PanBabinicz/tinyscope/hardware/kicad/tinyscope/tinyscope.kicad_pcb

## KiCad design TubesAndDrivers.kicad_sch

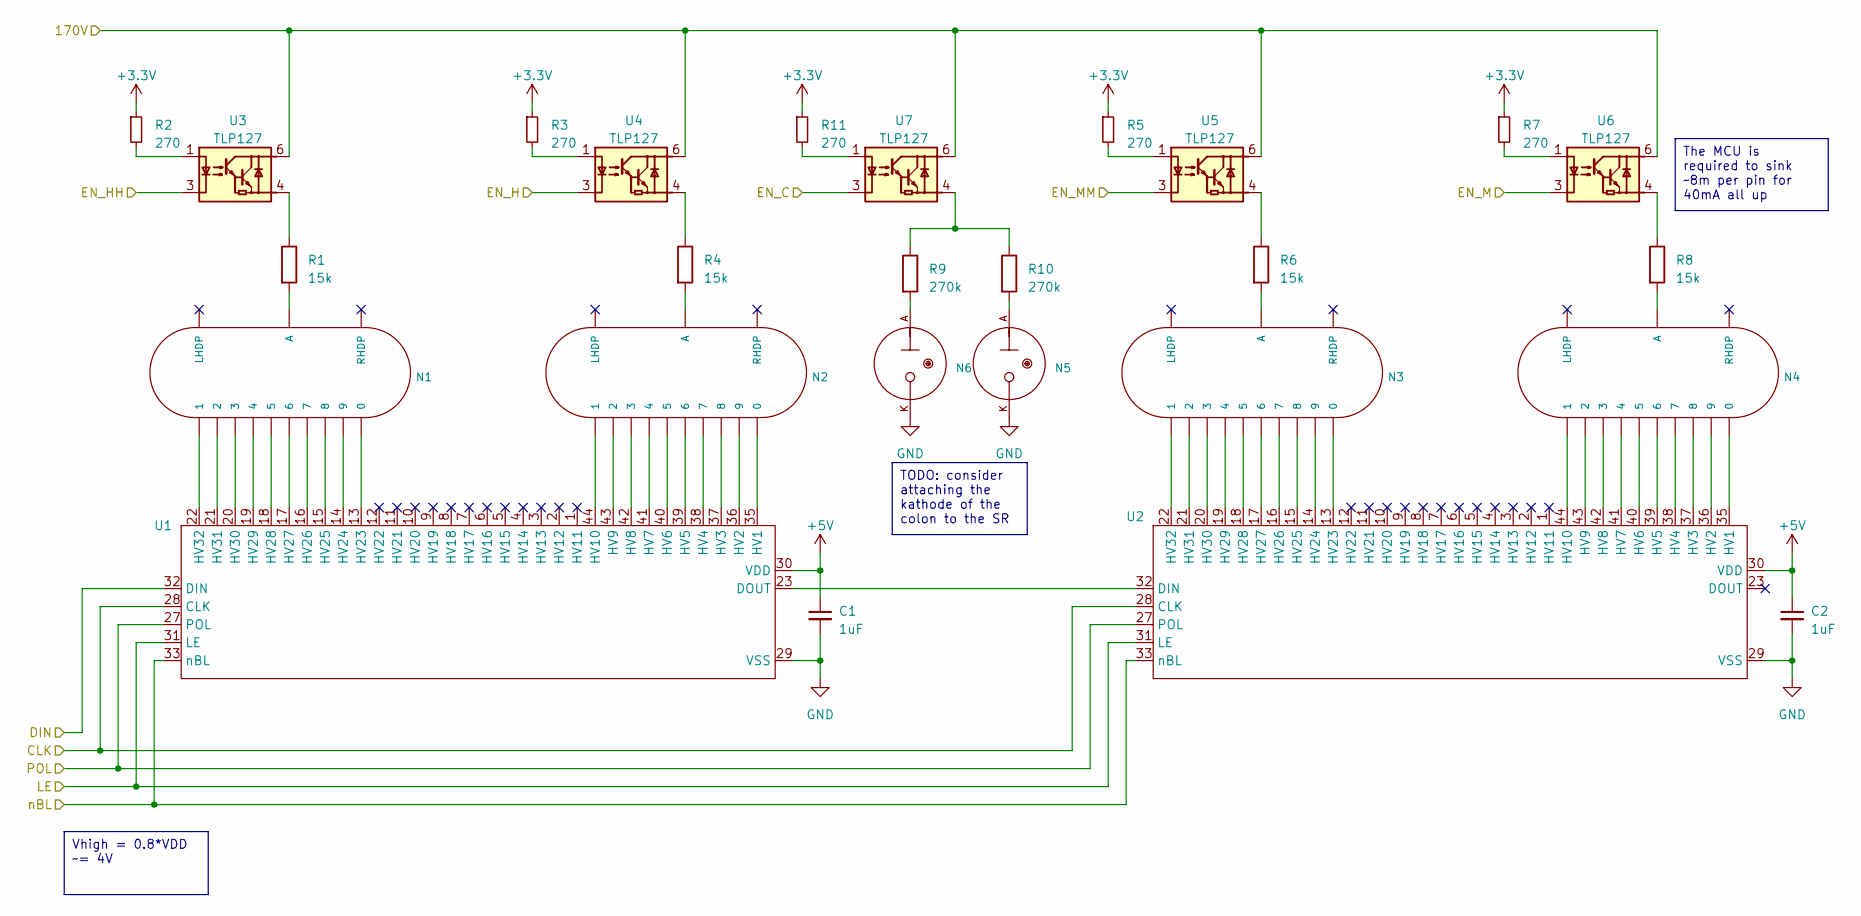
[picture p1: schematic TubesAndDrivers.kicad_sch]

Parts:
C1, C2: 1uF
N1, N2, N3, N4: IN-14; nixies-us_IN-14
N5, N6: IN-3; nixies-us_IN-3
R1, R4, R6, R8: 15k
R2, R3, R5, R7, R11: 270
R9, R10: 270k
U1, U2: QFN-44-1EP_7x7mm_P0.5mm_EP5.15x5.15mm
U3, U4, U5, U6, U7: TLP127; MFSOP6-4_4.4x3.6mm_P1.27mm

Connections:
170V: U3.6, U4.6, U5.6, U6.6, U7.6
+3.3V: R2.1, R3.1, R5.1, R7.1, R11.1
+5V: C1.1, C2.1, U1.30 (VDD), U2.30 (VDD)
CLK: U1.28 (CLK), U2.28 (CLK)
DIN: U1.32 (DIN)
EN_C: U7.3
EN_H: U4.3
EN_HH: U3.3
EN_M: U6.3
EN_MM: U5.3
GND: C1.2, C2.2, N5.K, N6.K, U1.29 (VSS), U1.45 (VSS), U2.29 (VSS), U2.45 (VSS)
LE: U1.31 (LE), U2.31 (LE)
unnamed: N1.0, U1.13 (HV23)
unnamed: N1.1, U1.22 (HV32)
unnamed: N1.2, U1.21 (HV31)
unnamed: N1.3, U1.20 (HV30)
unnamed: N1.4, U1.19 (HV29)
unnamed: N1.5, U1.18 (HV28)
unnamed: N1.6, U1.17 (HV27)
unnamed: N1.7, U1.16 (HV26)
unnamed: N1.8, U1.15 (HV25)
unnamed: N1.9, U1.14 (HV24)
unnamed: N1.A, R1.2
unnamed: N2.0, U1.35 (HV1)
unnamed: N2.1, U1.44 (HV10)
unnamed: N2.2, U1.43 (HV9)
unnamed: N2.3, U1.42 (HV8)
unnamed: N2.4, U1.41 (HV7)
unnamed: N2.5, U1.40 (HV6)
unnamed: N2.6, U1.39 (HV5)
unnamed: N2.7, U1.38 (HV4)
unnamed: N2.8, U1.37 (HV3)
unnamed: N2.9, U1.36 (HV2)
unnamed: N2.A, R4.2
unnamed: N3.0, U2.13 (HV23)
unnamed: N3.1, U2.22 (HV32)
unnamed: N3.2, U2.21 (HV31)
unnamed: N3.3, U2.20 (HV30)
unnamed: N3.4, U2.19 (HV29)
unnamed: N3.5, U2.18 (HV28)
unnamed: N3.6, U2.17 (HV27)
unnamed: N3.7, U2.16 (HV26)
unnamed: N3.8, U2.15 (HV25)
unnamed: N3.9, U2.14 (HV24)
unnamed: N3.A, R6.2
unnamed: N4.0, U2.35 (HV1)
unnamed: N4.1, U2.44 (HV10)
unnamed: N4.2, U2.43 (HV9)
unnamed: N4.3, U2.42 (HV8)
unnamed: N4.4, U2.41 (HV7)
unnamed: N4.5, U2.40 (HV6)
unnamed: N4.6, U2.39 (HV5)
unnamed: N4.7, U2.38 (HV4)
unnamed: N4.8, U2.37 (HV3)
unnamed: N4.9, U2.36 (HV2)
unnamed: N4.A, R8.2
unnamed: N5.A, R10.2
unnamed: N6.A, R9.2
unnamed: R1.1, U3.4
unnamed: R2.2, U3.1
unnamed: R3.2, U4.1
unnamed: R4.1, U4.4
unnamed: R5.2, U5.1
unnamed: R6.1, U5.4
unnamed: R7.2, U6.1
unnamed: R8.1, U6.4
unnamed: R9.1, R10.1, U7.4
unnamed: R11.2, U7.1
unnamed: U1.23 (DOUT), U2.32 (DIN)
unnamed: U1.25, U1.26, U1.34
unnamed: U2.25, U2.26, U2.34
POL: U1.27 (POL), U2.27 (POL)
nBL: U1.33 (nBL), U2.33 (nBL)

Notes on the sheet:
TODO: consider attaching the kathode of the colon to the SR
The MCU is required to sink ~8m per pin for 40mA all up
Vhigh = 0.8*VDD ~= 4V
