PanBabinicz/tinyscope/(commit log)

2026-05-31 feat: hardware: Add tinyscope kicad project. Add USBC part
    [tinyscope.kicad_pcb, tinyscope.kicad_sch]
2026-05-31 feat: hardware: Add tinyscope kicad project. Add USBC friendly battery charger part
    [tinyscope.kicad_sch]
2026-05-31 feat: hardware: Add tinyscope kicad project. Add fuel gauge part
    [tinyscope.kicad_sch]
2026-06-01 feat: hardware: Add tinyscope kicad project. Replace global labels with net labels
    [tinyscope.kicad_sch]
2026-06-01 feat: hardware: Add tinyscope kicad project. Add TPS54360 buck converter for battery #1
    [tinyscope.kicad_sch]
2026-06-02 feat: hardware: Add tinyscope kicad project. Add TPS54360 buck converter for battery #2. Add reverse-polarity and transient protection
    [tinyscope.kicad_sch]
2026-06-03 feat: hardware: Add tinyscope kicad project. Adds description blocks for Power Input & Charging section
    [tinyscope.kicad_sch]
2026-06-05 feat: hardware: Add tinyscope kicad project. Adds TPS62133 3V3 buck converter
    [tinyscope.kicad_sch]
2026-06-06 feat: hardware: Add tinyscope kicad project. Adds TPS63802 3V3 buck-boost converter instead of the previous one
    [tinyscope.kicad_sch]
2026-06-07 feat: hardware: Add tinyscope kicad project. Adds description to TPS63802 3V3 buck-boost converter
    [tinyscope.kicad_sch]
2026-06-07 feat: hardware: Add tinyscope kicad project. Adds TPS61023 5V boost voltage converter
    [tinyscope.kicad_sch]
2026-06-08 feat: hardware: Add tinyscope kicad project. Adds TPS63802 5V buck-boost converter instead of the TPS61023 (which input voltage range is too low)
    [tinyscope.kicad_sch]
2026-06-09 feat: hardware: Add tinyscope kicad project. Adds LM27761 -5V Switched-Capacitor Voltage Inverter
    [tinyscope.kicad_sch]
2026-06-10 feat: hardware: Add tinyscope kicad project. Adds REF3030 Voltage Reference 3.0V
    [tinyscope.kicad_sch]
2026-06-11 feat: hardware: Add tinyscope kicad project. Adds ADP742 low noise 5V LDO regulator
    [tinyscope.kicad_sch]
2026-06-12 feat: hardware: Add tinyscope kicad project. Divides project to subsheets. Adds power input and chargin sheet, regulation and rails sheet
    [power_and_charging.kicad_sch, regulation_and_rails.kicad_sch, tinyscope.kicad_sch]
2026-06-13 feat: hardware: Add tinyscope kicad project. Create flow diagram on Power Input & Charging schemat
    [tinyscope.kicad_sch]
2026-06-13 feat: hardware: Add tinyscope kicad project. Create flow diagram for Regulation & Rails schemat
    [regulation_and_rails.kicad_sch, tinyscope.kicad_sch]
2026-06-13 feat: doc: Adds stm32h753 reference manual and datasheet
2026-06-13 feat: hardware: Add tinyscope kicad project. Create flow diagram for MCUs sheet. Adds decoupling caps for STM32H743
    [mcus.kicad_sch, power_and_charging.kicad_sch, regulation_and_rails.kicad_sch, tinyscope.kicad_sch]
2026-06-14 feat: hardware: Add tinyscope kicad project. Adds SWD NRST and BOOT0
    [mcus.kicad_sch]
2026-06-15 feat: hardware: Add tinyscope kicad project. Adds HSE XTAL. Missing capacitor values
    [mcus.kicad_sch]
2026-06-15 feat: hardware: Add tinyscope kicad project. Adds LSE XTAL. Missing capacitor values
    [mcus.kicad_sch]
2026-06-16 feat: hardware: Add tinyscope kicad project. Divide MCU schematic into acquisition and wireless parts
    [mcus_acquisition.kicad_sch, tinyscope.kicad_sch]
2026-06-16 feat: hardware: Add tinyscope kicad project. Initializes MCU wireless schematic
    [mcu_wireless.kicad_sch]
2026-06-17 feat: hardware: Add tinyscope kicad project. Adds Raytac MDBT50Q #1
    [mcu_wireless.kicad_sch]
2026-06-18 feat: hardware: Add tinyscope kicad project. Adds Raytac MDBT50Q #2. Basic schemtic with TAG Connect
    [mcu_wireless.kicad_sch]
2026-06-18 feat: doc: Update schematics - title and revision
    [mcu_wireless.kicad_sch, mcus_acquisition.kicad_sch]
2026-06-19 feat: hardware: Add tinyscope kicad project. Add TAG Connect to STM32H743
    [mcus_acquisition.kicad_sch]
2026-06-19 feat: hardware: Add tinyscope kicad project. Adds STM32H743 SPI1 and SPI2 lines
    [mcu_wireless.kicad_sch, mcus_acquisition.kicad_sch]
2026-06-20 feat: hardware: Add tinyscope kicad project. Adds HMI schematic - display part #1
    [tinyscope.kicad_sch]
2026-06-20 feat: hardware: Add tinyscope kicad project. Adds ILI9341 display controller #1
    [hmi.kicad_sch]
2026-06-21 feat: doc: Adds AN2867 guidelines for oscillator design on STM32
2026-06-22 feat: hardware: Asigns load capacitors values for STM32H743 and saves crystals datasheet
    [mcu_wireless.kicad_sch, mcus_acquisition.kicad_sch]
2026-06-22 feat: hardware: Adds blue led mosfet driver for MDBT50Q
    [mcu_wireless.kicad_sch, power_and_charging.kicad_sch]
2026-06-23 feat: hardware: Finish MCU wireless schematic
    [mcu_wireless.kicad_sch, mcus_acquisition.kicad_sch]
2026-06-24 feat: hardware: Adds green led mosfet driver for STM32H743
    [mcus_acquisition.kicad_sch]
2026-06-25 feat: hardware: Adds five encoders in HMI schematic #1
    [hmi.kicad_sch]
2026-06-26 feat: hardware: Adds five encoders inputs on STM32H743
    [mcus_acquisition.kicad_sch]
2026-06-27 feat: hardware: Connects all five encoders to STM32H743
    [hmi.kicad_sch, mcus_acquisition.kicad_sch]
2026-06-28 feat: hardware: Adds RC filters for each A/B channels for all encoders
    [hmi.kicad_sch]
2026-06-30 feat: hardware: Adds RC filters for each switches for all encoders
    [hmi.kicad_sch]
2026-07-01 feat: hardware: Adds on/off switch for BQ24075
    [power_and_charging.kicad_sch]
2026-07-02 feat: hardware: Starts working on Front End A - general purpose
    [front_end.kicad_sch, tinyscope.kicad_sch]
2026-07-03 feat: hardware: Starts working on Front End B - ignition
    [tinyscope.kicad_sch]
2026-07-04 feat: hardware: Adds first stage TVS diodes for Front End A/B
    [front_end.kicad_sch]
2026-07-05 feat: hardware: Adds BV199 clamps and AD8065 buffers for Front End A/B
    [front_end.kicad_sch, regulation_and_rails.kicad_sch]
2026-07-06 feat: hardware: Finishes front ends stage 4
    [front_end.kicad_sch]
2026-07-07 feat: hardware: tidy: Adjust power and charging schematic to A4 format
    [power_and_charging.kicad_sch]
2026-07-08 feat: hardware: Add front ends stage 5. Replaces AD8065 with AD8066
    [front_end.kicad_sch]
2026-07-09 feat: hardware: note: The SPI1 has to be changed due to the fact that PA4 is used by DAC1_OUT
    [mcus_acquisition.kicad_sch]
2026-07-10 feat: hardware: Switches SPI1 to SPI4. Adds DAC1_OUT1 and DAC1_OUT2
    [front_end.kicad_sch, mcus_acquisition.kicad_sch]
2026-07-11 feat: hardware: Adds SPI4 connection on wireless mcu schematic
    [mcu_wireless.kicad_sch]
2026-07-12 feat: hardware: note: Starts the desing of the Sallen and Key Low Pass Filter filter (anti-aliasing)
    [front_end.kicad_sch]
2026-07-13 feat: hardware: note: Adds the two Sallen and Key Low Pass Filter filter (anti-aliasing) topologies
    [front_end.kicad_sch]
2026-07-14 feat: hardware: note: Adds the two Sallen and Key Low Pass Filter filter (anti-aliasing) parts values
    [front_end.kicad_sch]
2026-07-15 feat: hardware: Adds ADC12_INP3 and ADC12_INP4 fast channels
    [mcus_acquisition.kicad_sch]
2026-07-16 feat: hardware: note: Changes the caps values of two Sallen and Key Low Pass Filters (anti-aliasing) to match Butterworth filter
    [front_end.kicad_sch]
2026-07-18 feat: hardware: Adds the user input rotary encoders description. Changes 5V pull-up to 3V3
    [hmi.kicad_sch]
2026-07-19 feat: hardware: Adds wireless mcu description
    [mcu_wireless.kicad_sch]
2026-07-19 feat: hardware: Adds acquisition mcu description
    [mcus_acquisition.kicad_sch]
2026-07-20 feat: hardware: Adds decoupling capacitors for op amps and front end description
    [front_end.kicad_sch]
2026-07-21 feat: hardware: Adds rotary encoders on the main schematic
    [tinyscope.kicad_sch]
2026-07-23 feat: hardware: Adds Waveshare 16498 display 02x17 connector. Cleans up all schematics
    [hmi.kicad_sch, mcu_wireless.kicad_sch, mcus_acquisition.kicad_sch, power_and_charging.kicad_sch, regulation_and_rails.kicad_sch]
2026-07-24 feat: hardware: Modifies hmi description
    [hmi.kicad_sch]
2026-07-25 feat: hardware: Adds 6th encoder for display
    [hmi.kicad_sch]
2026-07-26 feat: hardware: doc: Modifies placement for the schematic description
    [front_end.kicad_sch, hmi.kicad_sch, mcu_wireless.kicad_sch, mcus_acquisition.kicad_sch]
2026-07-27 fix: hardware: Solves electrical rules warnings and errors #1
    [power_and_charging.kicad_sch]
2026-07-28 fix: hardware: Solves electrical rules warnings and errors #2
    [mcus_acquisition.kicad_sch]
2026-07-29 fix: hardware: Solves electrical rules warnings and errors #3
    [hmi.kicad_sch, mcu_wireless.kicad_sch, mcus_acquisition.kicad_sch, power_and_charging.kicad_sch]
2026-07-30 fix: hardware: Solves electrical rules warnings and errors #4
    [mcus_acquisition.kicad_sch]
2026-07-31 fix: hardware: Solves electrical rules warnings and errors #5
    [front_end.kicad_sch, mcus_acquisition.kicad_sch]
2026-08-01 feat: hardware: Adds connections subschematic
    [connections.kicad_sch, front_end.kicad_sch, mcus_acquisition.kicad_sch, tinyscope.kicad_sch]
2026-08-02 fix: hardware: Solves electrical rules warnings and errors #6
    [mcus_acquisition.kicad_sch]
2026-08-03 feat: hardware: Add global labels for acquisition mcu
    [mcus_acquisition.kicad_sch]
2026-08-03 feat: hardware: Adds no-connection flags for acquisition mcu
    [mcus_acquisition.kicad_sch]
2026-08-04 feat: hardware: Add global labels on power and charging, and regulation and rails subschematics
    [connections.kicad_sch, mcus_acquisition.kicad_sch, power_and_charging.kicad_sch, regulation_and_rails.kicad_sch]
2026-08-05 fix: hardware: Solves electrical rules warnings and errors #7
    [hmi.kicad_sch, power_and_charging.kicad_sch, regulation_and_rails.kicad_sch]
2026-08-06 feat: hardware: Adds connection subsheet description
    [connections.kicad_sch]
2026-08-07 fix: hardware: Solves electrical rules warnings and errors #8
    [connections.kicad_sch, mcus_acquisition.kicad_sch]
2026-08-08 feat: hardware: Maps waveshare display connections
    [connections.kicad_sch, mcus_acquisition.kicad_sch]
2026-08-09 fix: hardware: Solves electrical rules warnings and errors #9
    [hmi.kicad_sch, power_and_charging.kicad_sch, regulation_and_rails.kicad_sch]
2026-08-11 feat: hardware: Assigns footprints to USBC part
    [power_and_charging.kicad_sch]
2026-08-11 feat: hardware: Assigns footprints for resistors
    [front_end.kicad_sch, hmi.kicad_sch, mcu_wireless.kicad_sch, mcus_acquisition.kicad_sch, power_and_charging.kicad_sch, regulation_and_rails.kicad_sch]
2026-08-12 feat: hardware: Assigns footprints for AD8066ARZ op amp and encoders
    [front_end.kicad_sch, hmi.kicad_sch]
2026-08-13 feat: hardware: Assigns footprints for TPS63802DLAR voltage regulator and MAX17048 fuel gauge
    [power_and_charging.kicad_sch, regulation_and_rails.kicad_sch]
2026-08-14 feat: hardware: Assigns footprints for caps #1
    [power_and_charging.kicad_sch]
2026-08-15 feat: hardware: Assigns footprints for caps #2
    [power_and_charging.kicad_sch]
2026-08-16 feat: hardware: Assigns footprints for caps #3
    [front_end.kicad_sch, hmi.kicad_sch, mcus_acquisition.kicad_sch, power_and_charging.kicad_sch, regulation_and_rails.kicad_sch]
2026-08-17 feat: hardware: Assigns footprints for caps #4
    [power_and_charging.kicad_sch, regulation_and_rails.kicad_sch]
2026-08-17 feat: hardware: Finishes footprints selection for ADP7142 LDO
    [regulation_and_rails.kicad_sch]
2026-08-18 feat: hardware: Finishes footprints selection for REF3030 voltage reference
    [regulation_and_rails.kicad_sch]
2026-08-19 feat: hardware: Assigns footprints for caps #5
    [mcus_acquisition.kicad_sch, power_and_charging.kicad_sch]
2026-08-20 feat: hardware: Assigns footprints for connectors #1
    [hmi.kicad_sch, power_and_charging.kicad_sch]
2026-08-21 feat: hardware: Assigns footprints for diodes #1
    [power_and_charging.kicad_sch]
2026-08-22 feat: hardware: Assigns footprints for diodes #2
    [power_and_charging.kicad_sch]
2026-08-23 feat: hardware: Assigns footprints for inductors #1
    [power_and_charging.kicad_sch]
